apinise/Power-Supply/Schematic.pdf

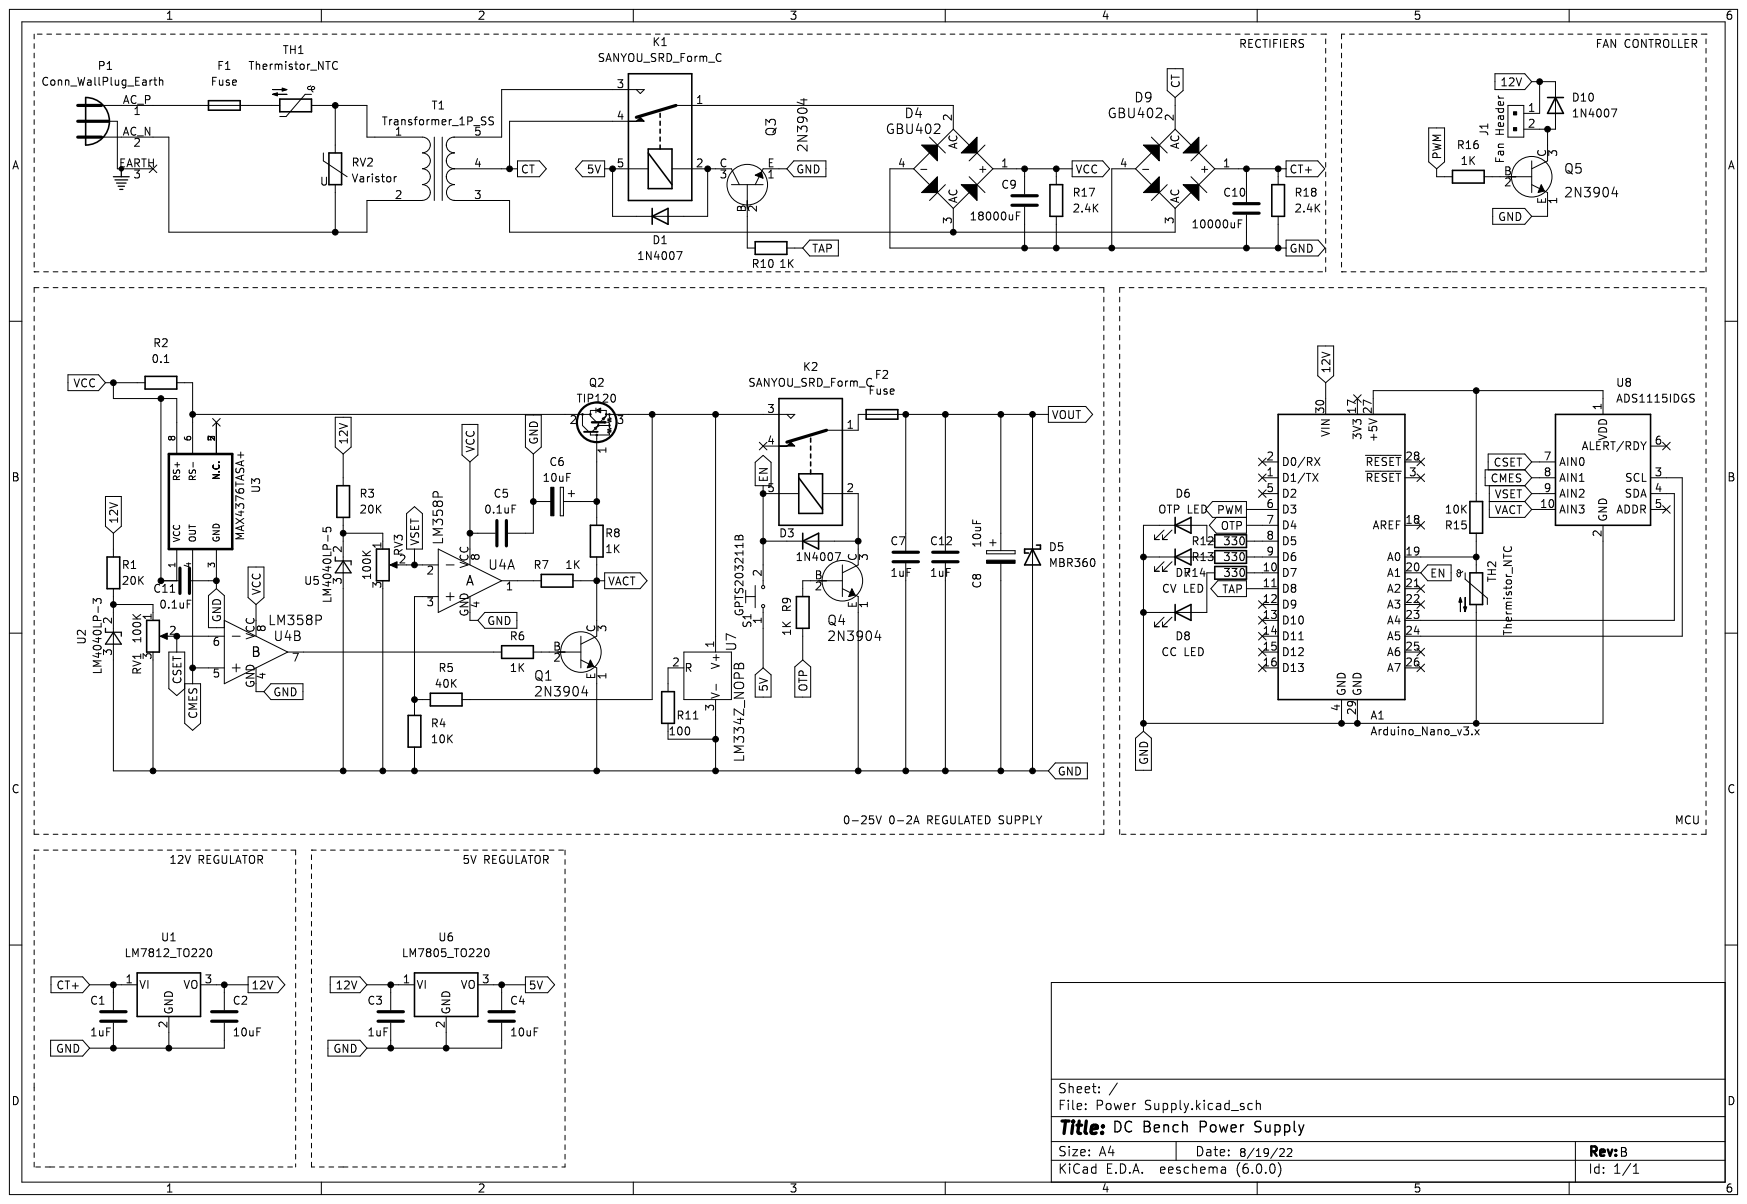
[picture p7: page 1]
