apinise/Power-Supply/(commit log)

2022-09-23 Create Schematics
2022-09-23 Create Gerbers
